jdswain/Verilog65C816/fpga/img/nextcube.png

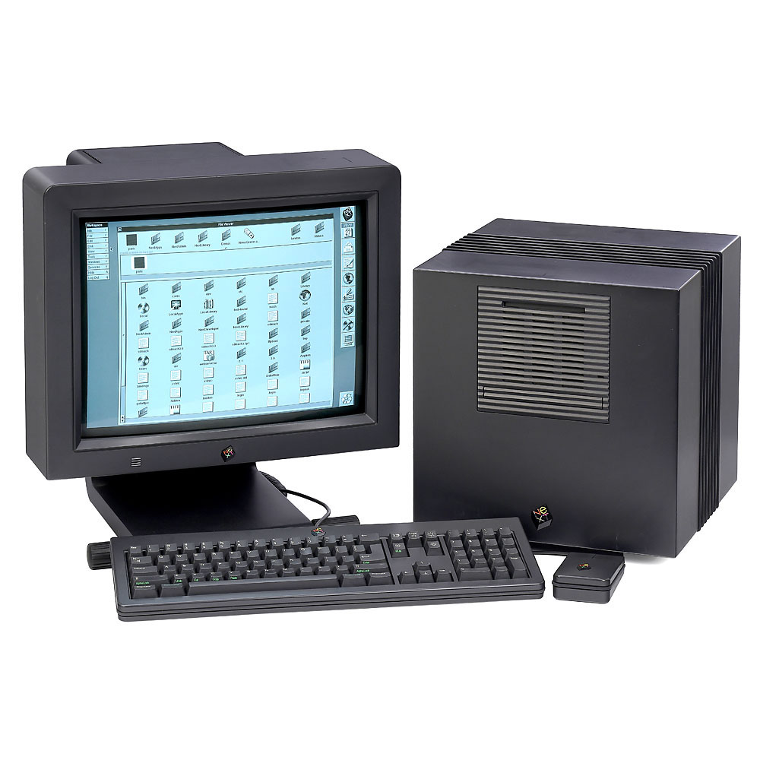
fpga/img/nextcube.png
