jdswain/Verilog65C816/docs/DMA.md

# DMA for SCSI, the floppy and Ethernet

**Built in the FPGA** (`rtl/dma.v`, `rtl/mm_mux.v`, tested by `sim/tb_dma.v`
and `rom/dmatest.asm`), and in em16 (`EmDMA.Mod`, tested by `test/dma.sh`);
the OS16 drivers are still to do. A three-channel DMA
engine in the FPGA that moves bytes between
SDRAM and the carrier's 53C80 (SCSI), 82077AA (floppy) and ENC424J600
(Ethernet), with a model of it in em16 and DMA modes in em16's two disk
chips, so that OS16's drivers can use it before the carrier exists. The
Ethernet channel (channel 2) is in the FPGA only so far; em16 is to follow. `Hardware.md` (DMA) has the pins and the
carrier's side; this document is the engine itself.

## Why

OS16's Floppy driver moves a sector by polling (OS16 `doc/OS16_ToDo.md`).
The 82077AA's 16-byte FIFO leaves 128-512 µs between the sector's first
byte and an overrun, and no gap that long after it. A clock interrupt takes
1.4 ms, so a polled transfer needs interrupts off from the READ to its
result, which includes the seek and up to a revolution: 200 ms or more.
With DMA each byte is served in hardware and interrupts and preemption stay
on. SCSI is handshaked and never overruns, but DMA frees the CPU during the
data phase, and the same engine serves both.

## Overview

```
        53C80 DRQ ──► DRQ0 ┐                   ┌──► port 2 ──► SDRAM
     82077AA DRQ ──► DRQ1 ┤   dma.v            │   (shared with the
  (ENC424J600: no request) │   3 channels ──────┤    blitter: mm_mux)
                          │   registers $0400  │
   /DACK (select codes 4, 1)◄─┤                └──► cache invalidation
   ENC data port ($0851) ◄─┤
   TC ◄───────────────────┤
                          └──► external_bus.v DMA port (one cycle at a time,
                                                     ahead of the CPU's)
```

| Channel | Device | Request | Acknowledge | Terminal count |
|---|---|---|---|---|
| 0 | 53C80 | `DRQ0`, pin 79 | select code 4 (`$0840` slot) | `TC`, inverted to `/EOP` |
| 1 | 82077AA | `DRQ1`, pin 80 | select code 1 (`$0810` slot) | `TC` |
| 2 | ENC424J600 | none: always ready | select code 5, A3-A0 = 1: the data port `$0851` | none |

The channel-to-device mapping is fixed. Each channel has a 24-bit address
and a 24-bit count and moves one byte per external bus cycle. On the memory
side bytes are gathered into words for writes and read sixteen at a time,
so the SDRAM sees one transaction per four or sixteen bytes.

**Ethernet.** The ENC424J600 needs no request pin: its packet buffer's
data windows are always ready, so channel 2 moves a frame unpaced, through
select 5 with `ext_a` = 1 (`$0851`, the latched window) instead of a
`/DACK` slot, and never with `TC`. Software latches the window first (a
write of `$80`, `$82` or `$84` to `$0850` for `EGPDATA`, `ERXDATA` or
`EUDADATA`); the chip's own window pointer does the rest. `Hardware.md`
(Ethernet) has the details; nothing on the carrier changes for it.
Software must leave the
chip alone while a transfer runs, interrupts included: the interrupt probe
reads `ESTAT`, which moves the latch, so the driver clears `EIE.INTIE` for
the length of the transfer and the probe doesn't read the chip meanwhile
(OS16 `doc/OS16_Network_Plan.md` §11).

## Prerequisite: the external bus

**Built** (step 1). The engine needs the bus as `Hardware.md` gives it:

* Intel-style `RD#`/`WR#` only, on the 8.4 MHz timing (about 400 ns a
  cycle). `EXT_STYLE`, PHI0 and the 6502 cycle are gone.
* The four select pins as a three-bit code and an active-low enable
  driving a 74HCT138: eight 16-byte slots at `$0800 + n*16`, mirrored every
  128 bytes. The enable keeps the `/DACK` outputs from glitching; on the
  53C80 a glitch on `/DACK` clears `DRQ`.
* The SCC recovery hold for select 2, and `RD#` with `WR#` during `RES#`.

The addresses software uses today don't move: the 82077AA at `$0800`, the
SCC at `$0820` and the 53C80 at `$0830`. This is step 1 of the plan below,
and it was worth doing on its own: every card access is two to four times
faster.

## Registers

At `$0400`, in the unclaimed `$0400`-`$04FF` range. The device decodes
`$0400`-`$043F`: `addr[5:4]` picks the channel, and `$0430`-`$043F`, a
fourth that doesn't exist, reads 0 and ignores writes. Each channel has 16
bytes:

| Offset | Register | Read | Write |
|---|---|---|---|
| +0, +1, +2 | ADDR | the next byte's address, low, middle, bank | the start address |
| +3 | | 0 | ignored |
| +4, +5, +6 | COUNT | the bytes left, low, middle, high | the bytes to move |
| +7 | | 0 | ignored |
| +8 | CTRL | as written; EN reads 0 once the channel stops | see below |
| +9 | STATUS | see below | bit 0: 1 clears DONE |
| +A-+F | | 0 | ignored |

Channel 0 is at `$0400`, channel 1 at `$0410`, channel 2 at `$0420`.

**CTRL**

| Bit | Name | |
|---|---|---|
| 0 | EN | 1 starts the channel and clears DONE, if it is not BUSY (if it is running it keeps running); 0 stops it |
| 1 | DIR | 0: device to memory (a read from the disk). 1: memory to device |
| 2 | TC | assert `TC` during the last byte's cycle. Channel 2: always 0 |
| 3 | IE | interrupt while DONE is set |
| 7-4 | | 0 |

**STATUS**

| Bit | Name | |
|---|---|---|
| 7 | BUSY | the channel is running, or has bytes still to write to memory |
| 6 | DRQ | the request line, as synchronised (for debugging). Channel 2: always 1 |
| 0 | DONE | the count reached 0 and every byte is in memory (or out on the bus) |

**The rules:**
* Every CTRL write sets IE. DIR and TC are taken when the channel starts.
  A start while the channel is still BUSY (stopped but not yet finished
  writing) is ignored: wait for BUSY to clear.
* ADDR and COUNT can only be written while the channel is stopped; writes
  while BUSY are ignored. They are plain bytes, so a 16-bit `sta` writes
  two of them.
* Starting with COUNT = 0 sets DONE at once, with no bus cycle.
* The address counts up through all 24 bits, across banks. It addresses
  SDRAM directly: `$00:0200`-`$00:0FFF` and the ROM overlay are the SDRAM
  under them, never I/O or ROM. Addresses at `$80:0000` and above wrap onto
  the SDRAM (`addr[22:0]`).
* **Stopping early.** Writing EN = 0 finishes the byte in progress, writes
  any gathered bytes to memory, and clears BUSY. DONE is not set. ADDR and
  COUNT then say exactly where the transfer stopped: SCSI uses this when the
  target changes phase before the count runs out.
* COUNT and ADDR change while the channel runs; reading three bytes of a
  running channel can tear. Stop it first, or wait for DONE.
* IRQ: the engine raises the CPU's IRQ while any channel has DONE and IE
  set; bits 1, 2 and 6 of the interrupt status at `$0440` say which
  (channels 0, 1 and 2). Writing 1 to STATUS bit 0 clears it.

### Programming a transfer

```
        ; channel 1: read a 512-byte sector into $02:4000
        sep #$20
        stz $0418           ; stopped (CTRL)
        lda #$00
        sta $0410
        lda #$40
        sta $0411
        lda #$02
        sta $0412           ; ADDR = $02:4000
        stz $0414
        lda #$02
        sta $0415
        stz $0416           ; COUNT = $000200
        lda #$0D            ; IE, TC, device to memory, EN
        sta $0418
        ; ... then the READ DATA command to the 82077AA
```

## The engine

`rtl/dma.v`, one module with three channel contexts, a memory-side state
machine and a bus-side state machine. Only one external bus cycle can
happen at a time, so the channels take turns for the bus; each has its own
memory buffers.

### Choosing a channel

A channel wants the bus when it is enabled, COUNT is not 0, its DRQ is
high, and (memory to device) its next byte is in its line buffer, or
(device to memory) its write buffer has room. When more than one want it,
they take turns, round robin from the one that had the last cycle. The
floppy then waits at most two other cycles, about 1 µs, against a FIFO that
lasts 128 µs at 1 Mbit/s and more at the slower rates.

Channel 2 has no DRQ: it wants the bus whenever it is enabled with bytes
left and its buffer ready, so it runs back to back. That doesn't lock the
CPU out. The bridge spends a clock idle after every DMA cycle before the
engine can ask again, and a waiting CPU access starts in it, so the CPU
still waits at most one DMA cycle (`tb_dma` checks this with channel 2 alone
and with all three running).

### The bus cycle

The bridge gets a second requester. A DMA cycle is a CPU cycle without an
address:

| | CPU cycle | DMA cycle |
|---|---|---|
| select code | `addr[6:4]` | 4 (channel 0), 1 (channel 1) or 5 (channel 2) |
| `ext_a[3:0]` | `addr[3:0]` | 0 (the chips ignore it during `/DACK`); 1 on channel 2, the ENC's data port |
| strobe | `RD#` read, `WR#` write | `RD#` device to memory, `WR#` memory to device |
| `TC` | low | high from T1 until the enable rises (40 ns after the strobe), on the last byte when CTRL.TC; never on channel 2 |
| timing | T1-T3 as in `Hardware.md` | the same |

The bridge takes a DMA request before a CPU one when both are waiting at
the start of a cycle, so a CPU access to the cards waits at most one DMA
cycle. The emulated SCC never goes through the bridge and never waits.

**Sampling DRQ again.** Both chips drop DRQ during the `/DACK` cycle if
they have no further byte. The engine ignores a channel's DRQ for
`DRQ_HOLD` (2) clocks after the bridge ends its cycle, which with the
two-clock synchroniser means DRQ must have fallen within 4 clocks (159 ns)
of the strobe rising. `tb_dma` models an 82077AA that drops it 119 ns
late; with a hold of 0 or 1 the engine reads its empty FIFO. **Check** the
82077AA's and 53C80's DRQ-from-strobe times against this; if either is
slower, raise `DRQ_HOLD`.

### The memory side

The engine is one master on port 2, behind `mm_mux` (below). It keeps the
port's protocol: it holds `req` through the cycle `done` is high and drops
it for a cycle after each `done`, so the CPU gets one transaction between
each of its own.

**Device to memory: a write buffer.** Each channel gathers bytes into a
32-bit word with a byte mask. The word goes to memory when its last byte
(address bits 1-0 = 3) is filled, when COUNT reaches 0, or when the channel
is stopped: a start or end that isn't word-aligned gives a partial mask.
A full word moves to a one-word queue and is written from there, so the
next byte can be gathered while it is written; the channel waits for the
bus only if the queue is still full when the next word fills, which at four
bus cycles a word does not happen. DONE is set only after the last write
has retired.

**Memory to device: a line buffer.** Each channel holds the sixteen bytes
of one aligned 16-byte block, read as one burst (four words). The block is
fetched when the channel starts and again each time the address crosses
into the next block. SCSI then stalls for one burst (about 0.5 µs) every 16
bytes, about 5%. A second line, fetched ahead, would remove that stall if it
matters. With logic short, the buffer can shrink to a word, at four times
the reads.

**Ordering against the CPU's stores.** The cache is write-through with one
store in flight: the CPU carries on before its store reaches SDRAM, and
port 2 outranks the CPU's port. A driver that fills a buffer and then
starts a channel could have the engine read a word whose store is still
waiting. So the cache exposes `wr_busy` (a store accepted but not yet
retired), and the engine doesn't issue a read while it is high (`tb_dma`
checks it). **Open:** the blitter has the same exposure and doesn't use
the signal yet.

**The cache.** The engine's writes go past the cache, which snoops port 2
already: `inv_valid`/`inv_addr` come from the multiplexed port instead of
the blitter's. The CPU's instruction queue doesn't snoop, as for the
blitter: code read from disk is only stale if it is within eight bytes of
the PC, and a jump to it empties the queue (`cpu_65c816.v`).

### `mm_mux`: sharing port 2

A small arbiter in front of port 2, between the blitter and the engine. A
master is granted when the port is idle and holds the grant until its
`done`. If both are asking, the engine wins: it has deadlines and the
blitter doesn't, and it asks at most once every four bus cycles. Read data
and `rvalid` go to the granted master; `done & we` with the granted
address go to the cache's invalidation input. Each master drops `req` for
a cycle after its `done`, but with two of them one could ask in the cycle
the other drops, so `mm_mux` also holds port 2's request low for the
cycle after every `done`: the CPU still gets its turn between any two
transactions.

### Throughput and cost

* **Rate:** a byte takes the bus cycle (12 clocks), the bridge's gap, the
  hold-off and the synchroniser: about 17 clocks, 1.5 MB/s at best.
  `tb_dma` measures 1.26 MB/s against a 53C80 model that raises DRQ again 5
  clocks after each strobe. The floppy needs at most 125 KB/s (2.88M), so
  it is never kept waiting long. Channel 2, with no DRQ to wait for,
  measures 1.57 MB/s; a 10 Mbit/s link fills the buffer at 1.25 MB/s.
* **SDRAM:** at the full SCSI rate, one word write every 2 µs, a few percent
  of the controller's time.
* **Logic:** measured in the Gowin build, the engine and `mm_mux` add about
  760 flip-flops and 1,340 logic cells: the SoC went from 72% to 78% of the
  logic, still at 33.5 MHz against 25.2. Channel 2 (with the power block,
  Nov 2026) took the SoC from 84% to 87% of the logic and from 28% to 30%
  of the registers, at 42.9 MHz against the 40.5 MHz system clock. The line
  buffers (3 x 128 bits) are the first thing to shrink if room runs short.

## Signals, pins and the carrier

From `Hardware.md`, unchanged: `DRQ0` on pin 79, `DRQ1` on pin 80 and `TC`
on pin 85, three new pins, plus the select decoder. Two points to add there:

* **The 82077AA tristates `DRQ` (and `INT`) while the DOR's DMA gate is
  off.** Its input to the 74LVC buffer would float. The carrier needs a
  pull-down on that input, on the 5V side. The 53C80's `DRQ` is driven
  (**Check**), but the same pull-down there costs nothing.
* **`TC` on both chips.** The 82077AA accepts `TC` only while `/DACK` is
  asserted (datasheet: "TC is accepted only while DACK is active"), so one
  shared pin serves both; the `Hardware.md` **Check** on this can be
  closed once it has been read against the datasheet itself.

**On the bare board** pin 80 reads high (its 10k pull-up to the SD card's
D2), so channel 1 always sees a request, and `ext_d` is pulled up, so it
reads `$FF`. A channel 1 transfer then runs to its count at bus speed: memory
to device sends bytes nowhere, device to memory fills memory with `$FF`.
That tests the memory side, the cache invalidation and the interrupt on the
board before the carrier exists. Pin 79 reads low (5.1k pull-down), so
channel 0 never runs.

## The chips' side

### 82077AA (channel 1)

* SPECIFY with ND = 0 (DMA mode), and the DOR's DMA gate on for the whole
  command: with the gate off, `DRQ` is tristated (and pulled down) and the
  transfer pauses.
* READ DATA: `DRQ` rises for each byte in the FIFO (with the FIFO on, it
  asks for bursts up to the threshold); each `/DACK` and `RD#` cycle takes
  one. WRITE DATA is the same with `WR#`.
* `TC` on the last byte of the last sector ends the command normally after
  that sector: ST0 `$00`, not the "end of cylinder" ending a polled transfer
  gets today. The result phase raises `INT`.
* In DMA mode `INT` comes only at the result phase (and for seeks), not for
  each byte. In the result phase the MSR shows RQM and DIO, so the driver's
  probe can tell a finished command without turning the gate off.

### 53C80 (channel 0)

* Mode register bit 1 (DMA mode), bit 3 (EOP interrupt) if the driver
  wants the chip's interrupt at the end; then write register 5 (start DMA
  send), 6 (start DMA target receive; not used) or 7 (start DMA initiator
  receive).
* `DRQ` asks for each byte while the phase matches; `/DACK` with `RD#`
  reads the input data register, `/DACK` with `WR#` writes the output data
  register. The chip does the REQ/ACK handshake by itself.
* `/EOP` (our `TC`) on the last byte sets End of DMA in the bus and status
  register, and interrupts if mode bit 3 is set.
* **The target can end the data phase early** (a short read, or a check
  condition). `DRQ` stops, phase match clears, and in DMA mode the chip
  interrupts. The driver then stops the channel and reads COUNT to see how
  many bytes moved.
* **The last byte of a send.** When the engine has written the last byte
  the chip still has it to hand over on the SCSI bus. The driver waits for
  it to go (the 53C80's "last byte sent", target command register bit 7,
  **Check**) before clearing DMA mode.

## em16

**Built** (65Tools `em16`). em16 had the 82077AA (`Em82077`) and the 53C80
(`EmSCSI`) at their carrier addresses, without DMA. The model has:

* **The eight-slot decode** in `EmSoC`'s card access (`card := AND(a DIV
  16, 7)`): today `$0840`, the 53C80's `/DACK` slot, decodes as the floppy.
  The CPU's accesses to slots 1 and 4 are pseudo-DMA: a byte from or to the
  chip, as a `/DACK` cycle with `TC` low.
* **`EmDMA`**, the engine: the same registers at `$0400`. Each `Tick`, a
  running channel whose device asks moves one byte, at most one every 13
  cycles (about the 400 ns cycle and the wait for DRQ), reading and writing
  memory through `EmSDRAM`. It raises its IRQ into `EmSoC`'s IRQ the way the
  cards do. Memory timing and the port 2 contention are not modelled.
* **`Em82077`'s DMA mode:** with ND = 0, DRQ and a `Dack(read, tc)`
  procedure instead of the warning. The bytes should arrive at the data
  rate, one per byte time (806, 403 or 201 cycles), not as fast as they are
  taken. Modelling the FIFO's overrun at the same time, as the OS16 ToDo
  asks, makes em16 fail where the board would.
* **`EmSCSI`'s DMA mode:** mode bit 1, start registers 5 and 7, DRQ while
  REQ is asserted and the phase matches, `Dack(read, eop)`, End of DMA, the
  EOP and phase-mismatch interrupts, and "last byte sent".
* **A test**, `test/dma.s`: sectors read and written by DMA on both
  devices, compared with the same sectors moved by programmed I/O; a stop
  partway through, checked against COUNT; and `TC` ending the floppy's
  command normally.

## OS16

The driver work, in outline (the drivers are OS16's to design):

* **Floppy:** SPECIFY with DMA, the gate on through the command, channel 1
  set up for the sector with TC and IE, READ or WRITE DATA, then Await. The
  probe sees either the engine's DONE or the controller's result phase
  (MSR RQM and DIO); both lead to reading the result. Seeks and
  recalibrates keep today's gate-toggling probe, since no DMA runs then.
* **SCSIManager:** the data phases by DMA, the rest by programmed I/O as
  now. Count = the bytes the command should move, TC on; wait for DONE or
  the 53C80's interrupt; stop the channel, read COUNT, clear DMA mode.
* **InterruptManager:** a probe for the engine (STATUS of each channel).
* **Ethernet:** frames in and out of the ENC424J600's buffer by channel 2,
  with the latch set first and the chip left alone until DONE (OS16
  `doc/OS16_Network_Plan.md` §11).

## Plan

Each step can be tested before the next starts.

1. **Done.** The external bus to one style, the 8.4 MHz timing and the eight-slot
   decode (`external_bus.v`, `top_tang20k.v`, the `.cst`, `fpga/README.md`).
   Test: the SoC simulation and a card bus model in a test bench; on the
   board, the timing on a logic analyser.
2. **Done.** The engine: `dma.v`, `mm_mux`, the bridge's DMA port, `wr_busy`
   from the cache, the IRQ, and the new pins (`DRQ0`, `DRQ1`, `TC`).
   `sim/tb_dma.v`: the engine with the bridge, a memory model and
   models of both chips (an 82077AA-like FIFO with a byte time, a
   53C80-like device that can change phase partway through): counts, TC on
   the last byte and only with `/DACK`, unaligned starts and ends, a stop
   with COUNT read back, CPU card accesses between DMA cycles, the store
   ordering, and turn-taking with both channels running. Then the SoC
   simulation, a timing build, and the bare-board test through `DRQ1`
   (`make dmatest`; it passes in the SoC simulation with `+drq1`, and has
   still to be run on the board).
3. **Done.** em16: the decode, `EmDMA`, and the two chips' DMA modes, with
   `test/dma.s`. The 82077AA's read bytes arrive at the data rate in DMA
   mode and overrun the FIFO if not taken; polled transfers still never
   overrun (the OS16 ToDo's item), so the polled driver keeps working.
4. **OS16:** Floppy, then SCSIManager, then a test that sectors move with
   interrupts on and other processes running.
5. **The carrier:** the DMA wiring and pull-downs, and the **Check** items
   above against the datasheets and the board.

6. **Done (FPGA).** Channel 2 for the ENC424J600: no request line, select 5
   with A3-A0 = 1 and no `TC`, round-robin turns among the three channels,
   its DONE on ISTAT bit 6. `tb_dma` adds a model of the chip's data port:
   a frame each way, all three channels at once with no FIFO overrun, the
   CPU waiting at most one DMA cycle while channel 2 runs back to back, and
   no write to the address latch from the engine. em16 and the OS16 driver
   are to follow.

Steps 1-2 are this repository's and step 3 is 65Tools'. They don't depend on
each other, since em16 implements the registers as this document gives them.
