jdswain/Verilog65C816/fpga/img/nextcube_preview.png

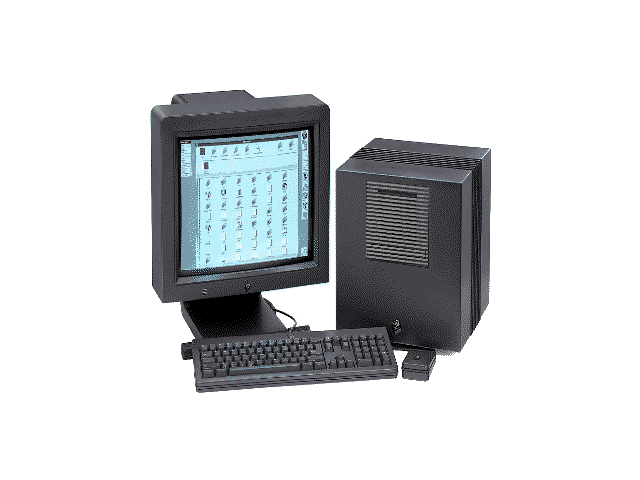
fpga/img/nextcube_preview.png
