jdswain/Verilog65C816/harte/failures.txt

=== 44.e: 7 pass, 93 fail ===
MISMATCH test 0 (cyc=10 done=1)
  exp pc=6245 s=0131 a=ffff x=0046 y=00ef d=3593 dbr=17 pbr=32 p=10110000 e=1
  got pc=0000 s=012e a=00000121 x=00000068 y=00000011 d=3593 dbr=e6 pbr=00 p=10110100 e=1
  ram[170012] exp b6 got 00
  ram[170013] exp 0d got 00
  ram[170014] exp 58 got 00
  ram[170015] exp 6e got 00
  ram[170016] exp d9 got 00
  ram[170017] exp 60 got 00
  ram[170018] exp 05 got 00
  ram[170019] exp 33 got 00
  ram[17001a] exp 80 got 00
  ram[17001b] exp 69 got 00
  ram[17001c] exp 42 got 00
  ram[17001d] exp 62 got 00
  ram[17001e] exp 7e got 00
  ram[17001f] exp 28 got 00
  ram[170020] exp 2a got 00
  ram[170021] exp 3a got 00
  ram[170022] exp 46 got 00
  ram[170023] exp 94 got 00
  ram[170024] exp 04 got 00
  ram[170025] exp 8c got 00
  ram[170026] exp 69 got 00
  ram[170027] exp c3 got 00
  ram[170028] exp 2a got 00
  ram[170029] exp 8b got 00
  ram[17002a] exp 5d got 00
  ram[17002b] exp cf got 00
  ram[17002c] exp 0a got 00
  ram[17002d] exp 35 got 00
  ram[17002e] exp bb got 00
  ram[17002f] exp f1 got 00
  ram[170030] exp e8 got 00
  ram[170031] exp fd got 00
  ram[170032] exp c1 got 00
  ram[170033] exp ec got 00
  ram[170034] exp 32 got 00
  ram[170035] exp d1 got 00
  ram[170036] exp 0a got 00
  ram[170037] exp 9e got 00
  ram[170038] exp 6c got 00
  ram[170039] exp 28 got 00
  ram[17003a] exp e1 got 00
  ram[17003b] exp 8b got 00
  ram[17003c] exp fe got 00
  ram[17003d] exp 56 got 00
  ram[17003e] exp 85 got 00
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
  ram[0000ff] exp 95 got 00
MISMATCH test 830 (cyc=9 done=1)
  exp pc=3434 s=01fe a=d470 x=0045 y=0098 d=ba99 dbr=f2 pbr=8f p=11111010 e=1
  got pc=3434 s=01fe a=0000d470 x=00000045 y=00000098 d=ba99 dbr=f2 pbr=8f p=11111010 e=1
  ram[0000ff] exp 7b got 00
