jdswain/Verilog65C816/fpga/sim/sd_card_model.v

//============================================================================
// sd_card_model.v -- an SDHC card in SPI mode, for simulation
//
// Enough of the SD Physical Layer spec's SPI mode for a block driver:
//   CMD0  GO_IDLE_STATE       R1; the CRC must be right ($95)
//   CMD8  SEND_IF_COND        R7, the voltage and check pattern echoed; the
//                             CRC must be right ($87 for $1AA)
//   CMD9  SEND_CSD            a version 2 CSD giving the image's size
//   CMD10 SEND_CID            a CID
//   CMD12 STOP_TRANSMISSION   R1b, ending CMD18
//   CMD13 SEND_STATUS         R2
//   CMD16 SET_BLOCKLEN        R1; only 512
//   CMD17 READ_SINGLE_BLOCK   R1, then $FE, 512 bytes and the CRC16
//   CMD18 READ_MULTIPLE_BLOCK R1, then blocks until CMD12
//   CMD24 WRITE_BLOCK         R1; then $FE and 512 bytes, answered $05 and
//                             busy for a few bytes
//   CMD25 WRITE_MULTIPLE      R1; then blocks after $FC, until $FD
//   CMD55 APP_CMD, ACMD41     idle for the first ACMD41, ready on the second
//   CMD58 READ_OCR            R3: powered up once ready, CCS set
// Anything else is answered as an illegal command. It is block addressed
// (SDHC), and CRCs other than CMD0's and CMD8's are not checked.
//
// The card answers a command after one $FF byte (NCR), and a read's data
// token after one more (NAC). It shifts MOSI in on the rising edge of SCLK
// and changes MISO on the falling edge (mode 0). Chip select going high
// abandons whatever it was sending. +sd=image.hex loads the image, a byte a
// line; without it there is no card and miso_oe stays low.
//============================================================================
`timescale 1ns/1ps

module sd_card_model #(
    parameter integer BLOCKS = 2048     // 1 MB
) (
    input  wire sclk,
    input  wire mosi,
    input  wire cs_n,
    output reg  miso = 1'b1,
    output wire miso_oe
);
    reg [7:0] mem [0:BLOCKS*512-1];
    reg present = 1'b0;
    reg [8*256-1:0] path;
    integer i;
    initial begin
        for (i = 0; i < BLOCKS*512; i = i + 1) mem[i] = 8'h00;
        if ($value$plusargs("sd=%s", path)) begin
            $readmemh(path, mem);
            present = 1'b1;
        end
    end
    assign miso_oe = present & ~cs_n;

    // What the card sends, a byte at a time.
    reg [7:0] q [0:2047];
    integer qh = 0, qt = 0;
    task push(input [7:0] b); begin q[qt] = b; qt = (qt + 1) % 2048; end endtask

    // CRC16-CCITT of a block, as a read sends it.
    function [15:0] crc16(input integer base);
        integer n, b;
        reg [15:0] c;
        begin
            c = 16'h0000;
            for (n = 0; n < 512; n = n + 1) begin
                c = c ^ {mem[base + n], 8'h00};
                for (b = 0; b < 8; b = b + 1)
                    c = c[15] ? {c[14:0], 1'b0} ^ 16'h1021 : {c[14:0], 1'b0};
            end
            crc16 = c;
        end
    endfunction

    task push_block(input integer blk);
        integer n;
        reg [15:0] c;
        begin
            push(8'hFF);                 // NAC
            push(8'hFE);                 // start block token
            for (n = 0; n < 512; n = n + 1) push(mem[blk*512 + n]);
            c = crc16(blk*512);
            push(c[15:8]); push(c[7:0]);
        end
    endtask

    // Command state
    reg [7:0]  cmd [0:5];
    integer    ncmd = 0;                 // command bytes collected
    reg        idle = 1'b1, app = 1'b0;
    integer    acmd41s = 0;
    reg        rd_multi = 1'b0;          // CMD18 running
    integer    rd_blk;
    // Writing: 0 none, 1 waiting for a token, 2 taking data
    integer    wr_state = 0, wr_blk, wr_n;
    reg        wr_multi = 1'b0;
    reg [7:0]  wr_buf [0:513];

    task r1(input [7:0] flags); begin push(8'hFF); push({7'd0, idle} | flags); end endtask
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
