jdswain/Verilog65C816/(commit log)

2026-10-13 65C816 CPU core and Tang Nano 20K system-on-chip
    A WDC 65C816 compatible core in Verilog with its test benches, and a
    system-on-chip around it for the Sipeed Tang Nano 20K: SDRAM with a
    cache and prefetch, HDMI text and framebuffer video, a blitter, a 6551
    serial port, an ADB keyboard host and an external bus. Boots MiniMon or
    Rockwell Forth from ROM.
2026-10-13 Build ROMs straight from the assembler; new test picture
    The ROM images are now Verilog memory files written by the 65Tools
    assembler (as -o name.mem), so tools/asimg.py and tools/elf2hex.py are
    gone. The files are byte-wide; soc.v reads a word as its two bytes.
    The ROM sources are in the current assembler's syntax (quoted section
    names, no entry directive) and carry their own reset vectors.
    The test picture is a NeXT cube instead of Lena. mkimage.py can allow
    for a monitor that stretches the picture (--display) and fill the
    surround with a colour other than black (--background).
2026-10-16 Emulated SCC for the console; target hardware spec
    Add rtl/scc_85c30.v, enough of a Z85C30 for a serial console, at
    $0820 where the Z85C80 on the carrier board will be. Channel A is the
    board's serial port; the ACIA stays on the same pins until nothing
    uses it. sim/tb_scc.v tests it. MiniMon now uses the SCC.
    Capture the ADB host's and blitter's read data on the strobe: their
    address-dependent read muxes had become the critical path (Fmax back
    to 30.0 MHz).
    docs/Hardware.md specifies the target board: the Z85C80, 82077AA and
    W5100S on an Intel-style 8 MHz external bus, DMA, interrupts, sound,
    pin allocation and a PCB requirements checklist. Correct the pin notes
    in the README and .cst from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
    [scc_85c30.v, soc.v, tb_scc.v]
2026-10-16 Remove the ACIA: the SCC is the serial port
    Everything now uses the emulated SCC at $0820: MiniMon, Business
    Basic, Rockwell Forth and the test ROMs, which share rom/scc.asm for
    its setup. Delete rtl/acia_6551.v; $0200 reads $FF. The ACIA had been
    raising receive interrupts nobody cleared once software stopped
    setting it up, which hung the Forth. Fmax rises to 32.0 MHz.
2026-10-17 Two SIDs on I2S, CERN-OHL-S licence, ADB keyboard working
    Sound: two SID chips at $0500-$053F, emulated by reDIP SID (vendored in
    rtl/sid at commit 5660867, CERN-OHL-S v2, with the changes Gowin needed
    listed in its README). sound.v gives them a 985248 Hz phi2, a posted
    write queue, shadow reads of OSC3 and ENV3, a lowpass and an I2S
    transmitter to the board's MAX98357A, on pins that were unused. A
    stereo DAC on the same pins would get both channels.
    The project is now licensed CERN-OHL-S v2.
    ADB: the keyboard works on a breadboard. It lost about half its keys
    when polled back to back, while answering every poll cleanly; it needs
    the bus idle between transactions (0.5 ms still lost keys, 2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
2026-10-19 Mandelbrot viewer for the 640x480 graphics mode
    apps/mandel.asm draws the set in 16 colours with s2.13 fixed point and
    a table of squares. Arrows/WASD pan, + - zoom, < > change the iteration
    limit, R resets, Q returns to MiniMon in text mode. Keys come from the
    serial port or the ADB keyboard. Build with `make mandel`, load and run
    with `make mandel-load`.
    [mandel.asm]
2026-10-21 Banked direct page and stack: D a bank and page, the stack in D's bank
    An extension of the core for preemptive multitasking (docs/BankedDP.md).
    WDM #$B1 turns it on and WDM #$B0 off; it is off at reset, so code that
    uses D as a bank 0 address is unaffected. In native mode with it on, the
    direct page is at DH:DL:00, and the stack, the stack-relative modes and
    the direct page pointers are in bank DH, so a process's direct page and
    stack are its D and S, and PHD/PLD, TCD/TCS move them. No instruction
    changes; other WDMs stay no-operations.
    banked.s checks it (make banked; em16 runs the same source); tb_cpu
    takes +hex= and zeroes its memory first. The Harte vectors pass as
    before, and timing is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
    [cpu_65c816.v, tb_cpu.v, tb_harte.v]
2026-10-21 fpga: MiniMon from OS16/rom, banked; Mandelbrot banked too
    MiniMon is now rom/ of the OS16 repository (MON_DIR defaults to
    ~/Developer/1av/65/OS16/rom). It turns banked mode on at reset and again
    when code run with go returns, so the operating system need not; its own
    direct page (0) and stack (page 1) are where they were. Mandelbrot sets
    the mode itself and gives its direct page as D = $003F.
    [mandel.asm]
2026-10-22 SCC: the baud-rate generator's zero-count external/status interrupt
    Each channel's generator counts from PCLK when WR14 bits 1-0 are set; a
    zero count latches the ext/status IP (WR15 bit 1, WR1 bit 0), seen in RR3
    and the vector, cleared by WR0 command 2. OS16's clock tick. tb_scc tests it.
2026-10-22 docs: the DMA engine for SCSI and the floppy
    docs/DMA.md designs the two-channel engine: registers at $0400, the
    bridge's DMA cycle, port 2 shared with the blitter, write gathering and a
    line buffer, ordering against the cache's posted store, em16's model and
    the chips' DMA modes, and a plan. Hardware.md points to it, and the carrier
    gets pull-downs on the DRQ inputs.
2026-10-22 External bus: Intel strobes at 8.4 MHz, eight slots through a '138
    The bridge is Intel RD#/WR# only, counted in a 119 ns bus clock (a cycle
    is about 560 ns to the CPU, from 1-2 us); the 6502 style, PHI0 and
    EXT_STYLE are gone. The four select pins are a three-bit code and an
    active-low enable for the carrier's 74HCT138: eight 16-byte slots,
    mirrored every 128 bytes. Slot 2 (the SCC) waits 595 ns between strobes,
    and RD# and WR# are held low while RES# is asserted, the SCC's reset.
    tb_extbus models the decoder and eight cards; exttest dumps the slots.
    Step 1 of docs/DMA.md.
    [external_bus.v, lint_top.v, soc.v, tb_extbus.v, top_tang20k.v]
2026-10-22 DMA engine: two channels for the carrier's SCSI and floppy
    rtl/dma.v moves bytes between SDRAM and the 53C80 (channel 0, DRQ0, /DACK
    slot 4) and the 82077AA (channel 1, DRQ1, slot 1): registers at $0400,
    24-bit ADDR and COUNT, TC on the last byte, DONE and an interrupt. Bytes
    are gathered into words for memory and read sixteen at a time; a fetch
    waits for the cache's posted store (new wr_busy). rtl/mm_mux.v shares
    port 2 with the blitter. The bridge gets a DMA port and TC, held until
    40 ns after the strobe. Pins 79, 80 and 85.
    tb_dma checks it against models of both chips; dmatest checks the memory
    side on the bare board, where DRQ1 is pulled high. 78% of the logic,
    33.5 MHz. Step 2 of docs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
2026-10-24 Add the tick timer and interrupt status register
    A 16-bit tick timer at $0450 (rtl/timer.v) for the OS clock, replacing
    the SCC channel B baud-rate generator: RELOAD in system clocks, EN,
    PENDING (write 1 to clear), and a 32-bit TICKS count latched with the
    down-counter by a read of $0458.
    $0440 shows which IRQ source is asking (timer, DMA channel 0 and 1,
    the cards' line, the emulated SCC) and $0441 masks them, $FF at reset.
    dma.v gains a per-channel interrupt output for it.
    Tests: tb_timer, and the timertest ROM in the SoC simulation, which
    takes real interrupts. Bitstream at 31.0 MHz, TNS 0. Docs updated, and
    DMA.md marks step 3 (em16) done.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
    [dma.v, soc.v, tb_timer.v, timer.v]
2026-10-26 Size the boot ROM to its image: 8, 16 or 32 KB
    tools/romimage.py makes the ROM the smallest of 8, 16 or 32 KB that holds
    the image, at $E000, $C000 or $8000, the image at its top with $FF
    below; the Makefile passes the size to synthesis and to tb_soc, so
    make sim ROM=rom/X.mem simulates the same ROM. An 8 KB image builds
    exactly as before. $0300 bit 0 maps out the whole range.
    rom/romsize.asm (make romsize) is a 16 KB ROM with its code at $C000.
    Simulated: romsize, timertest padded to 12 and 20 KB (16 and 32 KB
    ROMs), MiniMon. 16 KB ROM bitstream: 27/46 BSRAM, 32.3 MHz, TNS 0.
2026-10-27 Move ext_d[0] to pin 31; the edge headers in Hardware.md
    Pin 25 is HDMI CEC through 100R, so a connected monitor sat on data bit 0;
    ext_d[0] is now on pin 31 (J6-14) and pin 25 is unused. Hardware.md marks
    pin 31 and the four sound pins as built, and gains a J5/J6 table: each
    header position's FPGA pin and signal, the orientation (to be checked on
    the board) and the KiCad symbol and footprint.
2026-10-28 Hardware.md: level-shifter parts, FPGA-side pull-ups, interrupt fixes
    Name the level shifters (74LVC245A data, 74HCT541/138 outputs, 74LVC125A
    inputs, 74HCT04 inverters), list what needs no shifting, move the idle
    pull-ups and pull-downs to the FPGA side, and note the bus fight at the
    end of a read. Resolve the 82077AA checks from its datasheet (RESET active
    high, TC only with /DACK, INVERT grounded, 24 MHz crystal), add the INT
    pull-down and the W5100S /INT isolation.
2026-10-29 Hardware.md: the SCC's clock settled, no AppleTalk, its ports optional
    One 7.3728 MHz oscillator drives PCLK and both RTxC pins, with /SYNCA
    pulled up. AppleTalk is ruled out (its DPLL needs 3.6864 MHz on RTxC);
    networking will be Ethernet. The SCC stays because it comes with the
    SCSI half and needs no FPGA pins of its own; its MAX3232, connector and
    channel B header are optional, with pull-ups on the inputs when unfitted.
    The console is the BL616's.
2026-10-29 SD card: the microSD slot in SPI mode at $02C0
    sd_spi.v drives the Tang Nano's microSD slot as an SPI device on pins
    83 (SCLK), 82 (MOSI), 84 (MISO, pulled up) and 81 (CS): DATA, NEXT (a
    read sends $FF for the next byte), STATUS/CONTROL and DIVIDER, mode 0,
    393.75 kHz at reset and 12.6 MHz at DIVIDER 0. An access to DATA or
    NEXT while an exchange runs holds the CPU's I/O cycle until it ends, so
    software never polls; the hold is a register, adding no decode to rdy.
    sim/sd_card_model.v is an SDHC card in SPI mode; tb_sd_spi.v checks
    start-up, block reads and writes with their CRCs, NEXT back to back and
    at random spacings, and the clock rates. The SoC sim takes a card with
    +sd=image.hex. Hard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
    [lint_top.v, sd_card_model.v, sd_spi.v, soc.v, tb_sd_spi.v, tb_soc.v, top_tang20k.v]
2026-10-29 Core: an IRQ no longer abandons an opcode fetch that is waiting for rdy
    S_FETCH drops vld to take an interrupt, and irq2/nmi_pend could change
    while a fetch waited on SDRAM. The cache finished the abandoned read and
    its ack ended the interrupt's first push, which was never written: RTI
    then returned through a stale frame. irq2 and nmi_pend now change only as
    a bus cycle ends; an NMI edge waits in nmi_seen.
    tb_irqwait.v and irqwait.s (make irqwait): a banked-mode loop under a
    random IRQ, on a bus that finishes a request even after vld drops; the
    checksum must match the run without waits or IRQs, and the bus contract
    is checked every cycle.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
    [cpu_65c816.v, tb_irqwait.v]
2026-10-30 45 MHz: the core retimed, the SoC on its own clock
    The core: the bus address is a mux of registers (the next byte's address
    stepped a cycle ahead), and nothing computes on read data in the cycle it
    arrives. A read's operand and an implied opcode are latched and executed
    during the next opcode fetch; an RMW forms its result in its write cycle;
    pushes, WAI and STP take a setup cycle (S_IMP). Fmax 26.4 -> 37.8 MHz at
    about 1% more cycles. Harte: identical to before (only the MVN/MVP and two
    emulation-mode failures, as before); tb_harte runs the deferred execute.
    The SoC: a second PLL clocks the CPU, memory and peripherals at 45 MHz;
    video stays on the 25.2 MHz pixel clock, through video.v's li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
    [cpu_65c816.v, external_bus.v, soc.v, sys_pll.v, tb_harte.v, tb_soc.v, timer.v, top_tang20k.v]
2026-10-30 Core: an 8-byte instruction queue; cache hits in 2 cycles, a write buffer
    The core fetches a whole 32-bit word at a time into an 8-byte queue,
    in bus cycles it doesn't use, and decodes opcode and operand bytes from
    it; a jump empties the queue. Self-modifying code isn't supported.
    The cache acks a hit in its tag-check cycle (2 cycles, from 3), buffers
    up to 4 stores with merging, and instruction fills leave the held word
    alone. The blitter waits for the write buffer to drain, as DMA does.
    The boot ROM is 32 bits wide; prefetch.v is gone, replaced by the queue.
    rom/bench.s (make bench): sieve, sum, copy and walk from SDRAM take
    32-42% fewer cycles (295,829 -> 191,055). Timing 45.74 MHz agai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
    [cache.v, cpu_65c816.v, mm_mux.v, soc.v, tb_cpu.v, tb_harte.v, tb_irqwait.v]
2026-10-31 Docs: the rule for running code written by stores
    "Self-modifying code is not supported" overstated it. The cache is
    coherent with CPU stores; only the 8-byte instruction queue can hold
    stale bytes. Code written by stores runs correctly after a taken branch,
    jump, call, return or interrupt, or when every changed byte is 8 bytes
    or more past the storing instruction. OS16's module loader and
    BlockMove rely on this, so the split I/D-cache note now says an I-cache
    would have to snoop stores or come with an explicit invalidate.
    [cpu_65c816.v]
2026-11-04 HDMI: 1024x768 sync loss fixed; serializers on their own PLL output
    At 1024x768 the Tang Nano 20K lost HDMI sync under blitter traffic (the
    OS16 desktop, gtest19e): flashing, or black, depending on the 5x clock
    the serializers' reset release landed on, with our encoders and OSER10s
    and with Gowin's DVI_TX IP alike. 640x480 never had it.
    The fix is structural (video_pll.v, top_tang20k.v, hdmi_out.v). The
    serializers' FCLK is CLKOUTP, a PLL output of their own, in phase with
    the CLKOUT that feeds the pixel clock divider. Each reset is released by
    a flop on the clock of the cell it goes to, the serializers' one 5x
    clock after the divider's, the encoders' two pixel clocks later. A build
    with th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
    [hdmi_out.v, hdmitest.v, sdram_burst.v, soc.v, tb_blitter.v, tb_cache.v, tb_sdram_burst.v]
2026-11-07 HDMI: remove the hunt's diagnostics and the DVI_TX IP
    The 1024x768 sync-loss hunt left a set of diagnostics behind: the
    $0381-$03B0 register block with its PLL-lock and crystal counters, the
    HDMI kick, the LED chooser, the video module's debug counters and YIELD,
    the SDRAM controller's hold_bus, and Gowin's DVI_TX IP as an alternative
    output stage. All of it goes. The fix itself stays: the serializers' FCLK
    on its own PLL output with the per-cell release flops, the pipelined TMDS
    encoder, the PLL lock no longer resetting the SoC, the pin constraint
    changes and the place/route options. The testbenches lose the hold_bus
    port again.
    Verified: lint, make sim, tb_sdram_burst, tb_cache, tb_blitte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
    [sdram_burst.v, soc.v, tb_blitter.v, tb_cache.v, tb_sdram_burst.v, tb_soc.v, tb_video.v]
2026-11-07 Docs: the carrier as drawn in the 65-16 schematic
    Hardware.md gains a Drawn status and follows the schematic: the
    ENC424J600 replaces the W5100S at select 5 (parallel mode 5, the register
    map, the glue and the interrupt buffer); the serial ports are Mac
    Mini-DIN-8s at RS-422/423 levels; SCSI has an internal 50-pin header and
    an external DB-25 with socketed termination; the floppy's PC/AT
    configuration and 2.88 MB support; power is a 24-pin ATX header with
    every rail from the supply, and the Tang Nano's 5 V pin measured as USB
    VBUS; a Slot section for the Apple II form slot on the Intel bus; the
    PCB checklist ticked for what is drawn. The README's select table
    follows.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
2026-11-07 Docs: soft power on the carrier
    The carrier now has optional soft power: the ADB power key or a case
    button turns the ATX supply on through a latch on +5VSB, and the FPGA turns
    it off by toggling its LED pin at about 10 kHz. Only a fast toggle reaches
    the latch, so the LED still works as a power LED; it must never be PWMed.
    FPGA 53 (DDC clock) reads the power key through a Schottky. The pin tables
    mark pin 20 and pin 53 accordingly, DDC data (52) is now the last spare,
    and the ADB and checklist entries for keyboard power-on are closed.
2026-11-07 FPGA: soft power and the power LED at $0480
    The carrier's soft power turns the ATX supply off when the FPGA toggles
    its LED pin at about 10 kHz, so the LED becomes the power LED and the off
    line at once. power.v keeps the two apart: the pin changes at most once
    every 16 ms from software, and only OFF ($0482, write $A5) produces the
    50 ms burst. The old heartbeat is gone; the LED is steady from reset.
    The power key comes in on pin 53 (the HDMI DDC clock, pulled up on the
    Tang Nano), debounced. STATUS ($0480) shows KEY and a latched PRESSED,
    which can interrupt as ISTAT bit 5 with CONTROL's IE (off at reset, so
    existing software sees no new source). Holding the key for 4 seconds
    turns the sup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
    [lint_top.v, power.v, soc.v, socdbg.v, tb_power.v, tb_soc.v, top_tang20k.v]
2026-11-08 Docs: pre-order checks, Ethernet DMA, the still-to-do list
    The two checks due before the carrier is ordered are done. The DB-25 SCSI
    pinout matches Apple's table (Technote HW 10) on all 25 pins; pin 25
    carries TERMPWR as on later Macs. The Am85C80's chip enables are as wired,
    /CE1 the SCC and /CE2 the 53C80, and the symbol's 68 pins match the PLCC
    pinout in AMD's datasheet. The USB-C plug clears the parts in front of the
    Tang Nano.
    Ethernet DMA needs no pin: the ENC424J600's data windows are always
    ready, so a third, unpaced DMA channel through $0851 can move a frame. It
    must yield to the CPU's external cycles, and nothing may touch the chip's
    other registers meanwhile, the interrupt probe'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
2026-11-08 FPGA: DMA channel 2 for the ENC424J600
    The DMA engine gets a third channel for the Ethernet chip. The ENC424J600
    has no request line and needs none: its packet buffer's data windows are
    always ready, so channel 2 runs unpaced, each cycle an ordinary access to
    slot 5 at A3-A0 = 1 ($0851, the data port at the window software latched
    beforehand), never with TC. Its registers are at $0420 (reg_addr now six
    bits; $0430-$043F reads 0), its DONE with IE is ISTAT bit 6, CTRL.TC reads
    0 and STATUS.DRQ reads 1. The bridge's DMA port gains the address.
    dma.v is generalised to three channel contexts: two-bit channel indices,
    round-robin turns for the bus, and the memory queue served floppy first.
    The C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
2026-11-08 Docs: the rule kept for running code written by stores
    Code written by stores, DMA or the blitter is guaranteed to run correctly
    when a taken branch, jump, call, return or interrupt comes between the
    write and running it: that empties the core's instruction queue, the only
    place stale code can sit, since the cache is coherent with CPU stores and
    drops lines the other masters write. Later changes to the core keep this
    true; an I-cache would have to snoop stores or flush on the jump. The
    8-byte distance that also works today is how this queue behaves, not a
    promise. MVN and MVP read their bank bytes once, at the start (again only
    after an interrupt mid-move), so patched banks need the jump as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
    [cpu_65c816.v]
2026-11-08 Docs: stereo on the 65-16 by a breakout, and sound for the final board
    The 65-16 (rev A) has no audio of its own. Stereo can still be tried on it
    once the board works: the three I2S lines reach the Tang Nano's socket on
    the carrier as named nets that go nowhere, so a PCM5102A breakout wired to
    U3's pads 7 (BCLK), 11 (LRCK) and 8 (DIN), with 3.3V and ground and its
    SCK grounded, gives line-level stereo with the control register's stereo
    bit. The final board, with the FPGA on it, needs sound of its own, since
    the Tang Nano's amplifier and speaker connector go with it: the PCM5102A
    with a line-out jack, and an amplifier for a speaker.
2026-11-08 Docs: a real-time clock, on a slot card and later the final board
    The carrier has no clock that keeps time with the power off. Two routes,
    used together: NTP once Ethernet works, and a battery-backed DS12C887
    (MC146818-compatible, the PC AT's clock, crystal and cell in the package)
    on the external bus through the slot. Selects 6 and 7 go only to the
    slot, which carries the data and address lines, the raw strobes, /RES
    and /IRQ, so a small card in another SlotBoard slot can carry the clock
    with no FPGA pins and no change to the 65-16: a write to $0860 latches
    the register index (AS), $0861 moves the data (/CS with RD# or WR#), as
    the PC AT's ports 70h and 71h did. Its bus timing is to be chec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
2026-11-09 Docs: the real-time clock on the 65-16 rev B
    The DS12C887 moves from a slot card onto the carrier, at select 7:
    $0870 written is the register index and $0871 is that register, with
    one SN74LV27A making AS and /CS. The Real-time clock section now covers
    the glue, why it must be the LV27A, the interrupt and reset wiring, and
    the bus timing checked against the DS12887/DS12C887 datasheet, all met.
    The summary, select, register, slot and interrupt tables and the parts
    checklist follow; select 6 stays the slot's alone. The to-do list swaps
    the slot card for the OS16 driver, NTP and an em16 model.
2026-11-11 Docs: the DRQ buffer is a 74AHC125
    The 74LVC125A has no DIP package, so the carrier's DRQ buffer (U7) is a
    74AHC125 (SN74AHC125N) at 3.3V. Its inputs take up to 5.5V whatever its
    supply, and at 3.3V a high needs 2.31V, which the 53C80's and 82077AA's
    CMOS outputs give easily. The level-shifting table, the DMA note and the
    checklist say so.
2026-11-13 Core: the 65C832, and an extension behind WDM (MUL/DIV, shifts, BSW)
    cpu_65c816.v is now also WDC's 65C832 (docs/65C832.md): the hidden bits
    E16 and E8, a native mode whose accumulator is 8, 16 or 32 bits and whose
    index registers are 8 or 32, 4-byte immediates, operands, pushes and
    pulls, 8-digit decimal, index registers that reach all 16 MB, block moves
    past 64 KB, XFE ($42 $FB), and the 65C832 vectors at $FFD4-$FFDF. With
    E16 = 1, as at reset, it is the 65C816 it was.
    WDM ($42) is a prefix: before an ADC, AND, CMP or EOR opcode it makes
    MUL, UML, DIV or UDV in all fifteen of that opcode's addressing modes
    (X:A := A * M; A := quotient, X := remainder, rounded down), before
    $0A/$4A/$8A/$2A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
    [cpu_65c816.v, soc.v, tb_cpu.v, tb_harte.v, test832_gen.py]
